pjgranieri/Portable-Real-Time-Poker-Assistant/data/Datasets/SampleGameDataset/Cards/HoleCards/ESP32S3_OV5640_249504.jpg

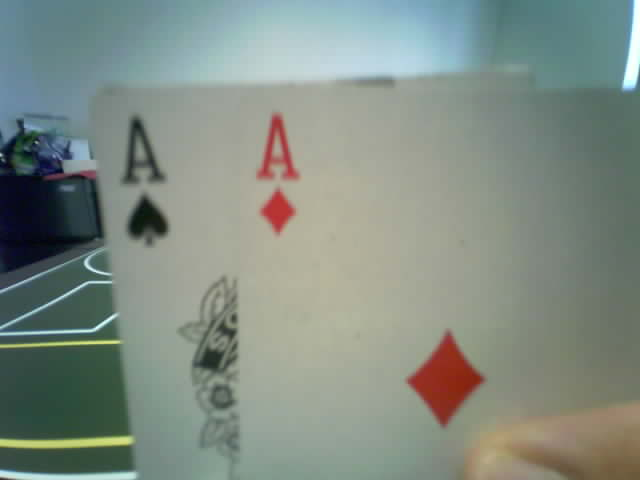
data/Datasets/SampleGameDataset/Cards/HoleCards/ESP32S3_OV5640_249504.jpg
