pjgranieri/Portable-Real-Time-Poker-Assistant/data/Datasets/SampleGameDataset/BettingCycles/RiverBetting/P2/Check/ESP32S3_OV5640_711521.jpg

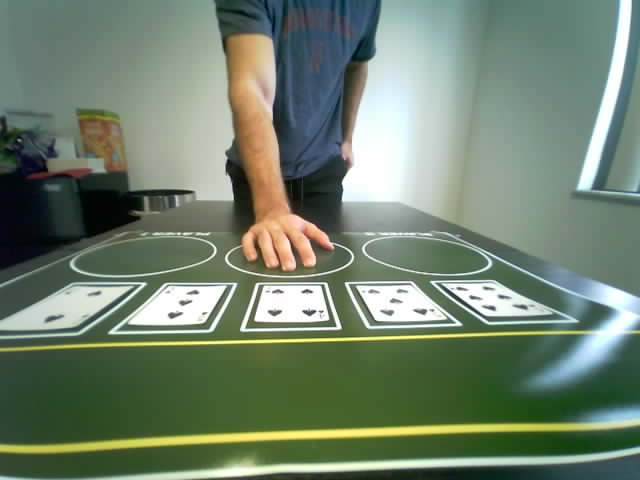
data/Datasets/SampleGameDataset/BettingCycles/RiverBetting/P2/Check/ESP32S3_OV5640_711521.jpg
