pjgranieri/Portable-Real-Time-Poker-Assistant/data/Datasets/CVDataset/BlackChips/1Chip/ESP32S3_OV5640_27438.jpg

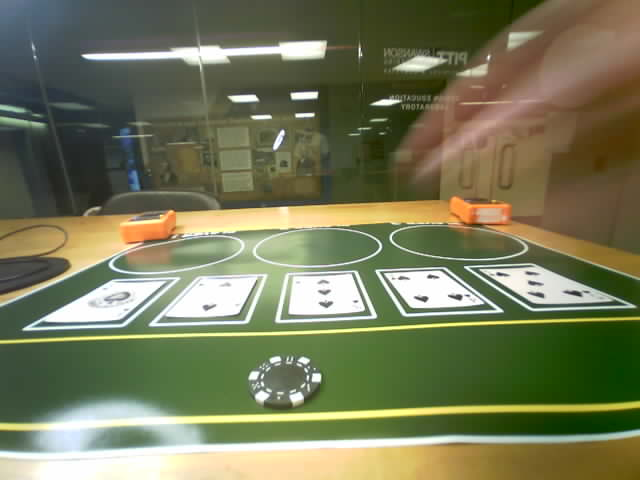
data/Datasets/CVDataset/BlackChips/1Chip/ESP32S3_OV5640_27438.jpg
