pjgranieri/Portable-Real-Time-Poker-Assistant/data/Datasets/CVDataset/BlackChips/1Chip/ESP32S3_OV5640_32523.jpg

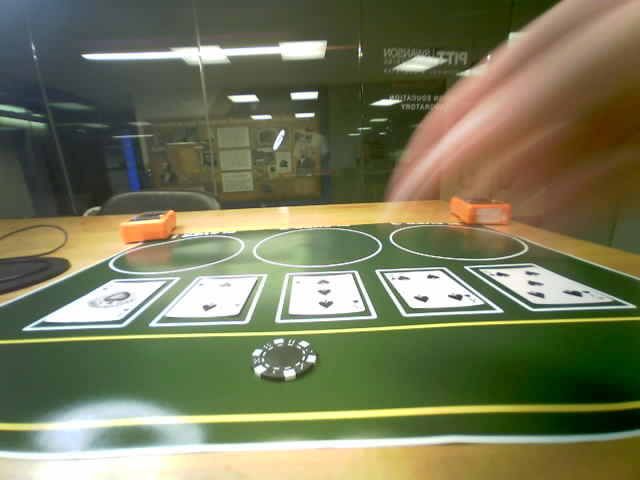
data/Datasets/CVDataset/BlackChips/1Chip/ESP32S3_OV5640_32523.jpg
