pjgranieri/Portable-Real-Time-Poker-Assistant/data/Datasets/CVDataset/BlackChips/1Chip/ESP32S3_OV5640_39970.jpg

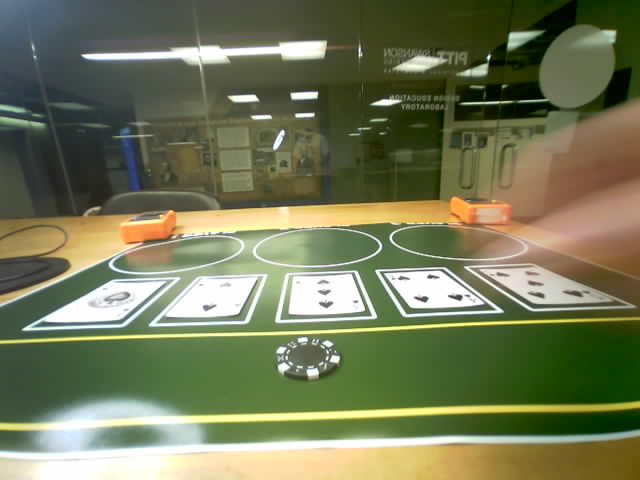
data/Datasets/CVDataset/BlackChips/1Chip/ESP32S3_OV5640_39970.jpg
