pjgranieri/Portable-Real-Time-Poker-Assistant/data/Datasets/CVDataset/BlackChips/2Chips/ESP32S3_OV5640_853156.jpg

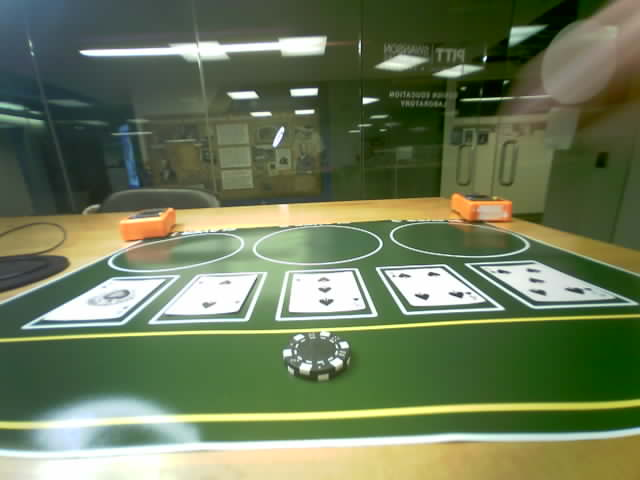
data/Datasets/CVDataset/BlackChips/2Chips/ESP32S3_OV5640_853156.jpg
