pjgranieri/Portable-Real-Time-Poker-Assistant/data/Datasets/CVDataset/BlackChips/3Chips/ESP32S3_OV5640_737669.jpg

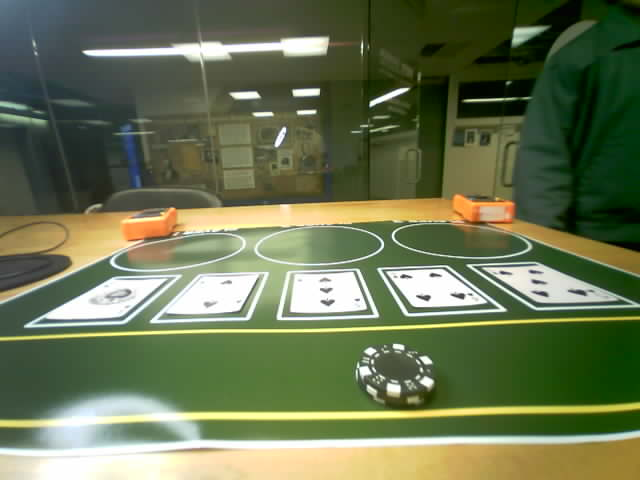
data/Datasets/CVDataset/BlackChips/3Chips/ESP32S3_OV5640_737669.jpg
