pjgranieri/Portable-Real-Time-Poker-Assistant/data/Datasets/CVDataset/BlackChips/4Chips/ESP32S3_OV5640_536933.jpg

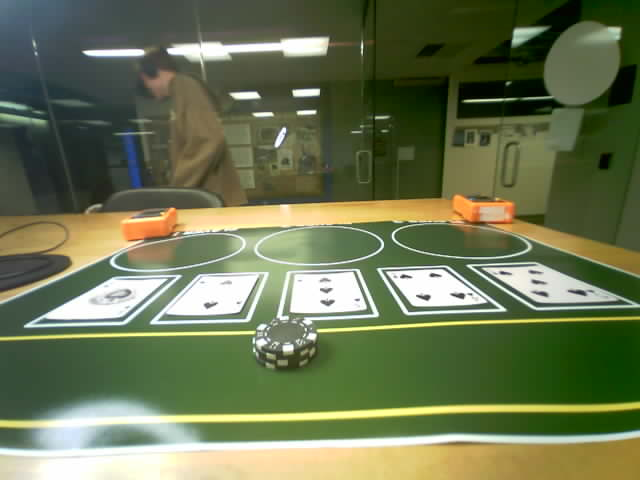
data/Datasets/CVDataset/BlackChips/4Chips/ESP32S3_OV5640_536933.jpg
