pjgranieri/Portable-Real-Time-Poker-Assistant/data/Datasets/CVDataset/BlackChips/4Chips/ESP32S3_OV5640_538406.jpg

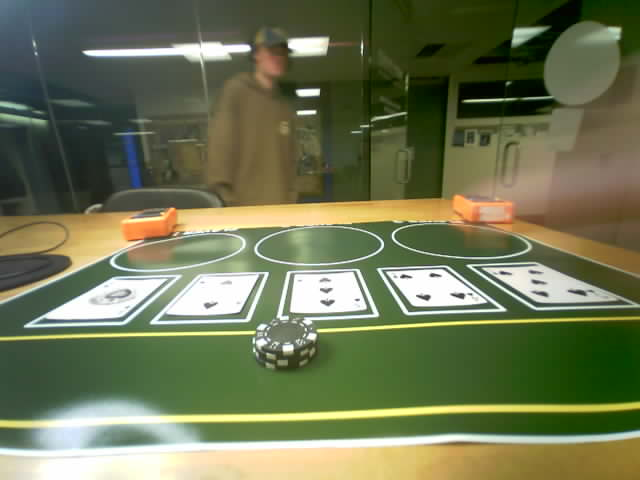
data/Datasets/CVDataset/BlackChips/4Chips/ESP32S3_OV5640_538406.jpg
