pjgranieri/Portable-Real-Time-Poker-Assistant/data/Datasets/CVDataset/BlackChips/5Chips/ESP32S3_OV5640_432432.jpg

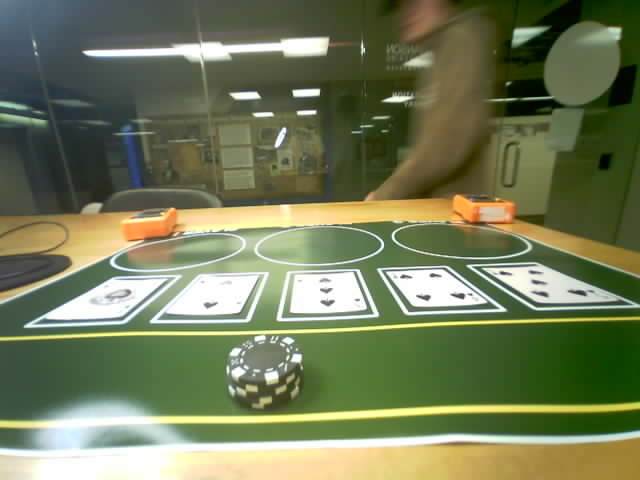
data/Datasets/CVDataset/BlackChips/5Chips/ESP32S3_OV5640_432432.jpg
