pjgranieri/Portable-Real-Time-Poker-Assistant/data/Datasets/CVDataset/BlueChips/1Chip/ESP32S3_OV5640_324995.jpg

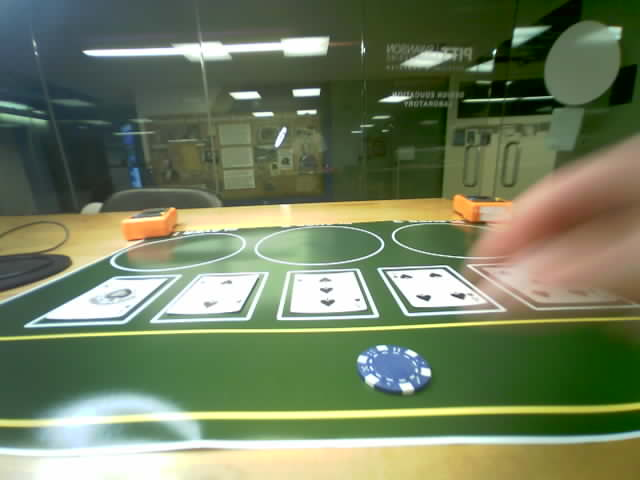
data/Datasets/CVDataset/BlueChips/1Chip/ESP32S3_OV5640_324995.jpg
