pjgranieri/Portable-Real-Time-Poker-Assistant/data/Datasets/CVDataset/BlueChips/4Chips/ESP32S3_OV5640_423402.jpg

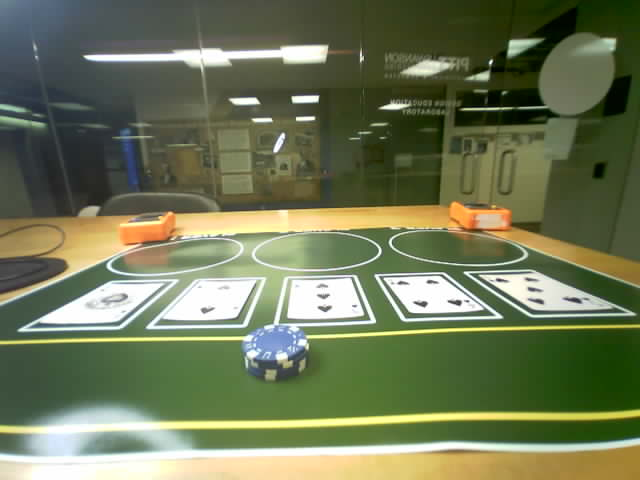
data/Datasets/CVDataset/BlueChips/4Chips/ESP32S3_OV5640_423402.jpg
