pjgranieri/Portable-Real-Time-Poker-Assistant/data/Datasets/CVDataset/BlueChips/4Chips/ESP32S3_OV5640_431127.jpg

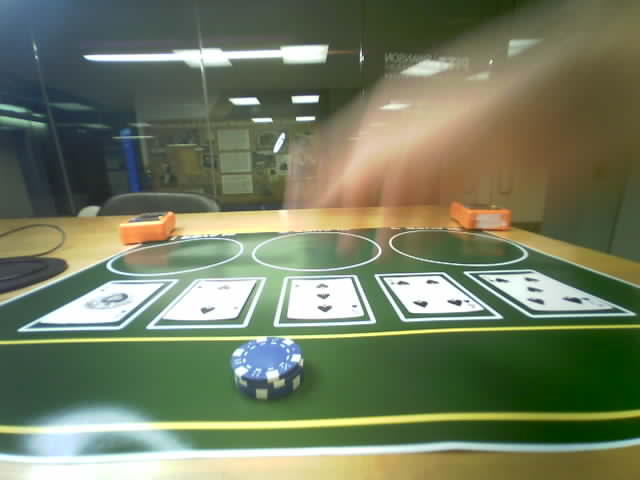
data/Datasets/CVDataset/BlueChips/4Chips/ESP32S3_OV5640_431127.jpg
