pjgranieri/Portable-Real-Time-Poker-Assistant/data/Datasets/CVDataset/BlueChips/4Chips/ESP32S3_OV5640_457952.jpg

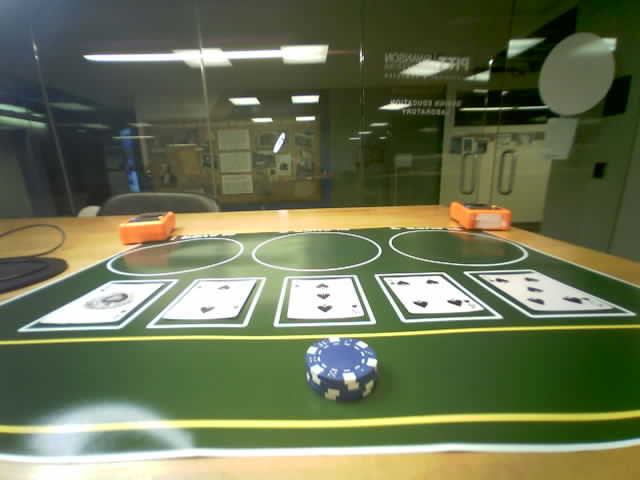
data/Datasets/CVDataset/BlueChips/4Chips/ESP32S3_OV5640_457952.jpg
