pjgranieri/Portable-Real-Time-Poker-Assistant/data/Datasets/CVDataset/RedChips/3Chips/ESP32S3_OV5640_774054.jpg

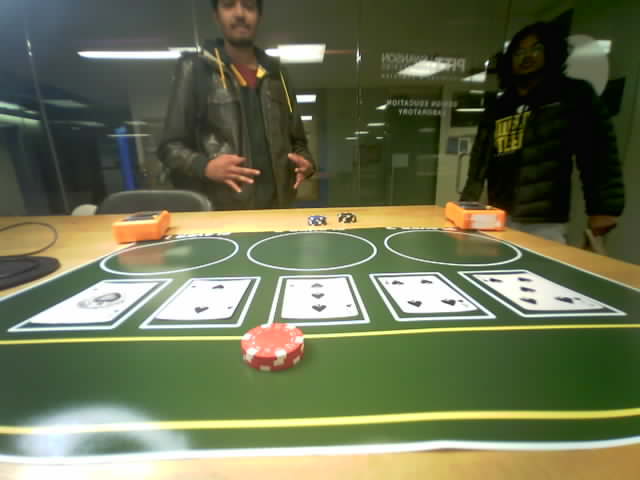
data/Datasets/CVDataset/RedChips/3Chips/ESP32S3_OV5640_774054.jpg
