pjgranieri/Portable-Real-Time-Poker-Assistant/data/Datasets/CVDataset/RedChips/3Chips/ESP32S3_OV5640_810843.jpg

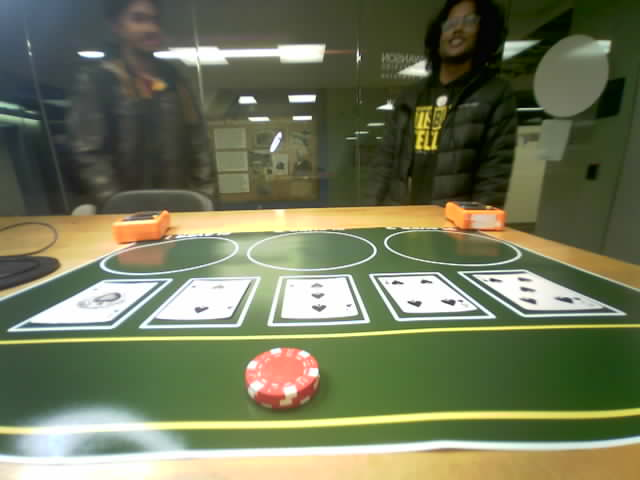
data/Datasets/CVDataset/RedChips/3Chips/ESP32S3_OV5640_810843.jpg
