pjgranieri/Portable-Real-Time-Poker-Assistant/data/Datasets/CVDataset/RedChips/3Chips/ESP32S3_OV5640_822369.jpg

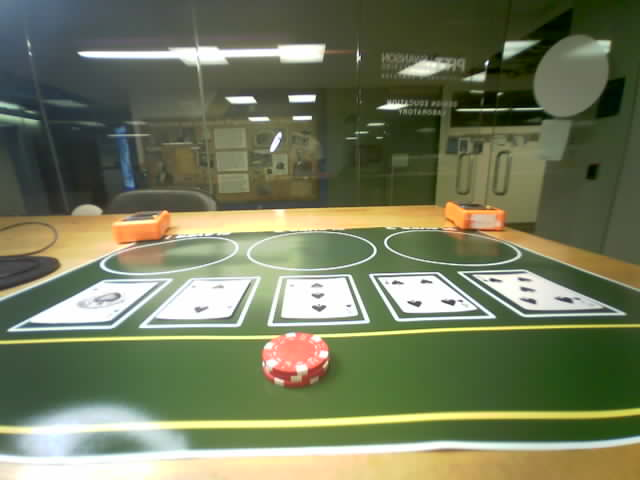
data/Datasets/CVDataset/RedChips/3Chips/ESP32S3_OV5640_822369.jpg
