pjgranieri/Portable-Real-Time-Poker-Assistant/data/Datasets/CVDataset/RedChips/3Chips/ESP32S3_OV5640_870761.jpg

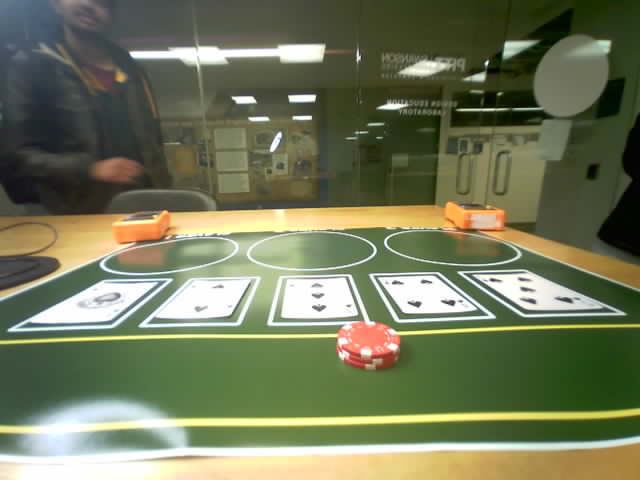
data/Datasets/CVDataset/RedChips/3Chips/ESP32S3_OV5640_870761.jpg
