pjgranieri/Portable-Real-Time-Poker-Assistant/data/Datasets/CVDataset/RedChips/5Chips/ESP32S3_OV5640_233298.jpg

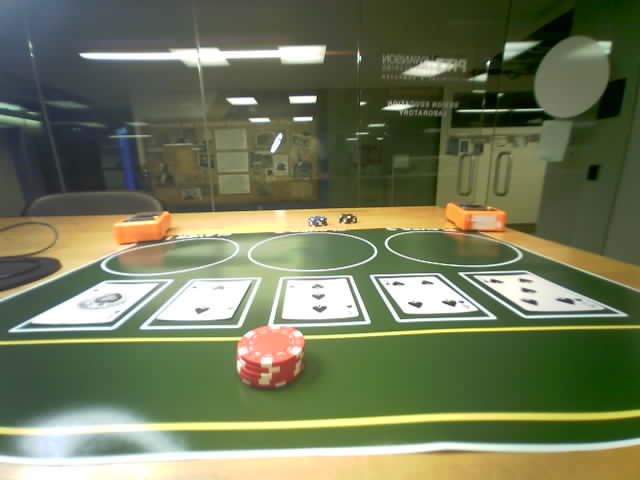
data/Datasets/CVDataset/RedChips/5Chips/ESP32S3_OV5640_233298.jpg
