pjgranieri/Portable-Real-Time-Poker-Assistant/data/Datasets/CVDataset/RedChips/5Chips/ESP32S3_OV5640_341674.jpg

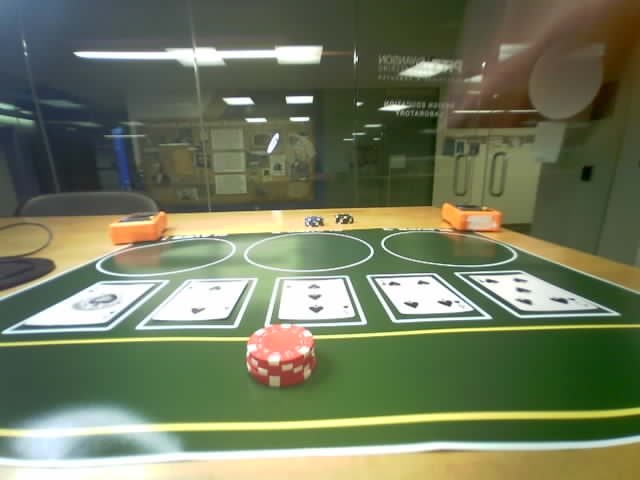
data/Datasets/CVDataset/RedChips/5Chips/ESP32S3_OV5640_341674.jpg
