pjgranieri/Portable-Real-Time-Poker-Assistant/data/Datasets/SampleGameDataset/BettingCycles/FlopBetting/P1/BlueChips/ESP32S3_OV5640_871948.jpg

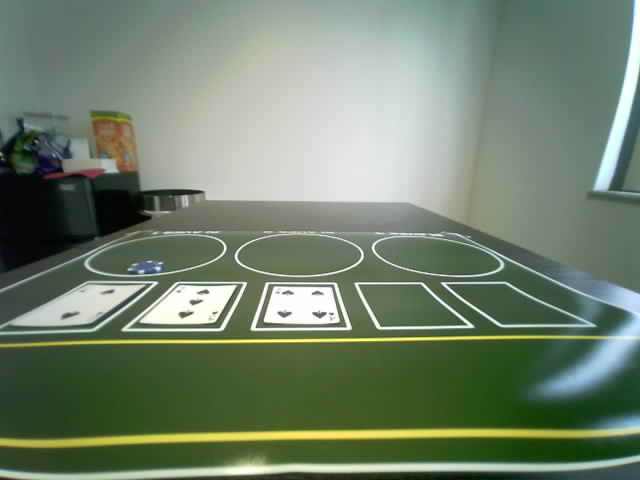
data/Datasets/SampleGameDataset/BettingCycles/FlopBetting/P1/BlueChips/ESP32S3_OV5640_871948.jpg
