pjgranieri/Portable-Real-Time-Poker-Assistant/data/Datasets/SampleGameDataset/BettingCycles/FlopBetting/P1/Check/ESP32S3_OV5640_1007601.jpg

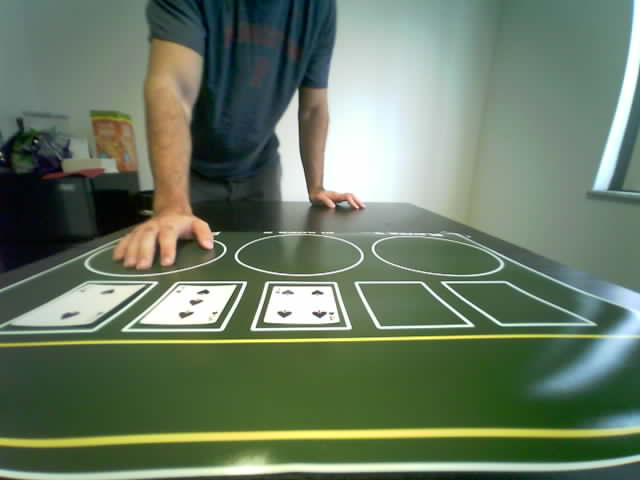
data/Datasets/SampleGameDataset/BettingCycles/FlopBetting/P1/Check/ESP32S3_OV5640_1007601.jpg
