pjgranieri/Portable-Real-Time-Poker-Assistant/data/Datasets/SampleGameDataset/BettingCycles/FlopBetting/P1/Fold/ESP32S3_OV5640_947596.jpg

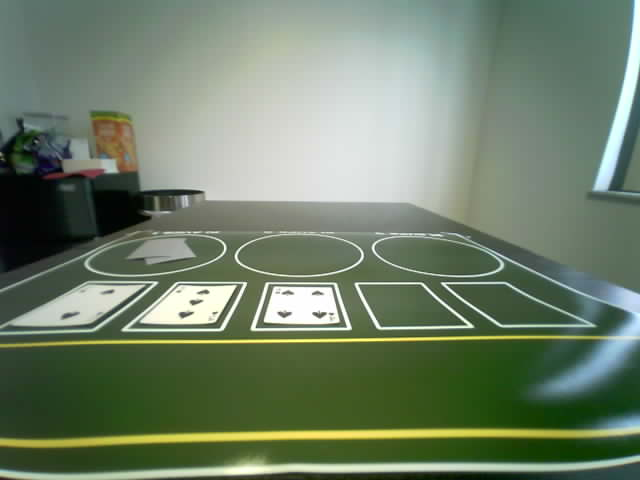
data/Datasets/SampleGameDataset/BettingCycles/FlopBetting/P1/Fold/ESP32S3_OV5640_947596.jpg
