pjgranieri/Portable-Real-Time-Poker-Assistant/data/Datasets/SampleGameDataset/BettingCycles/FlopBetting/P2/BlueChips/ESP32S3_OV5640_1161729.jpg

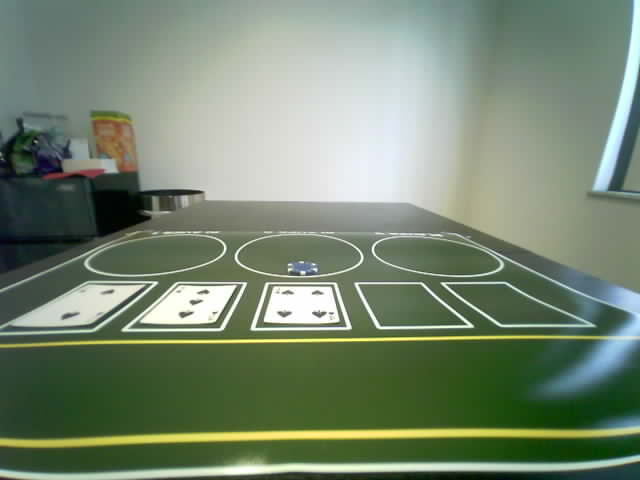
data/Datasets/SampleGameDataset/BettingCycles/FlopBetting/P2/BlueChips/ESP32S3_OV5640_1161729.jpg
