pjgranieri/Portable-Real-Time-Poker-Assistant/data/Datasets/SampleGameDataset/BettingCycles/FlopBetting/P2/Fold/ESP32S3_OV5640_1222649.jpg

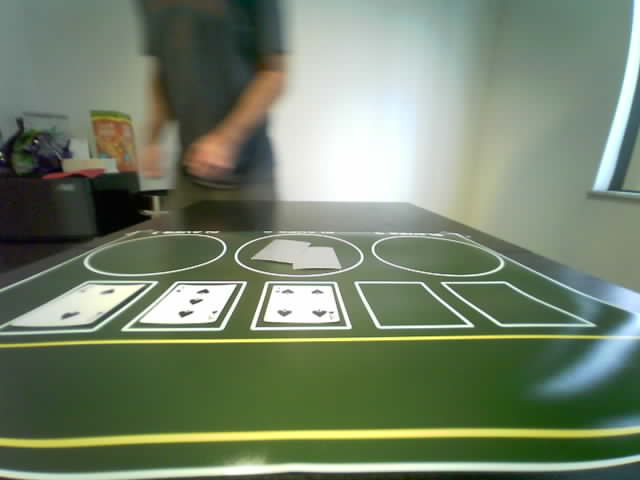
data/Datasets/SampleGameDataset/BettingCycles/FlopBetting/P2/Fold/ESP32S3_OV5640_1222649.jpg
