pjgranieri/Portable-Real-Time-Poker-Assistant/data/Datasets/SampleGameDataset/BettingCycles/FlopBetting/P3/BlueChips/ESP32S3_OV5640_1355583.jpg

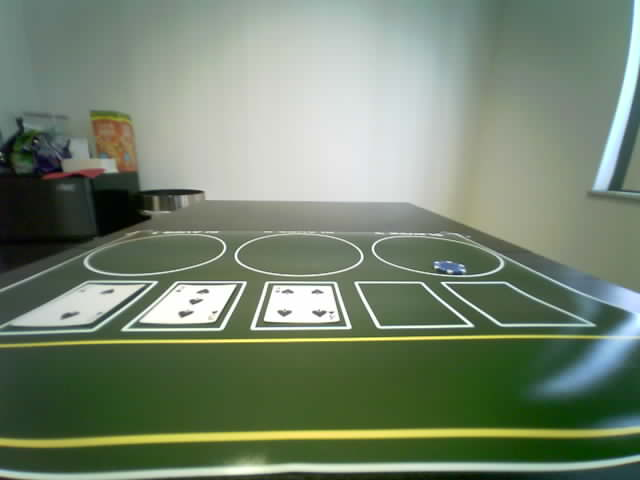
data/Datasets/SampleGameDataset/BettingCycles/FlopBetting/P3/BlueChips/ESP32S3_OV5640_1355583.jpg
