pjgranieri/Portable-Real-Time-Poker-Assistant/data/Datasets/SampleGameDataset/BettingCycles/FlopBetting/P3/Check/ESP32S3_OV5640_1460840.jpg

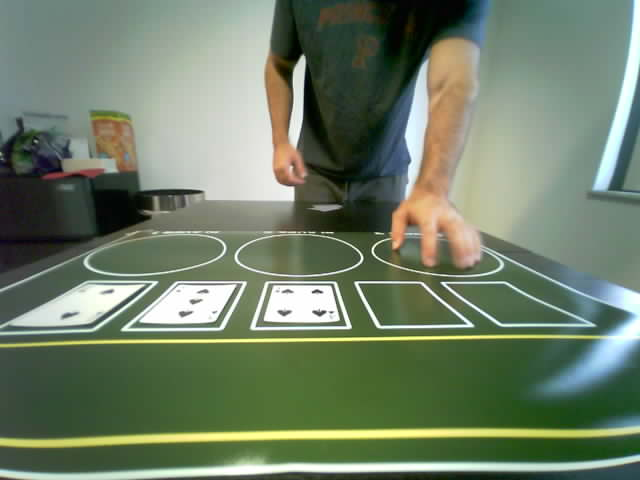
data/Datasets/SampleGameDataset/BettingCycles/FlopBetting/P3/Check/ESP32S3_OV5640_1460840.jpg
