pjgranieri/Portable-Real-Time-Poker-Assistant/data/Datasets/SampleGameDataset/BettingCycles/FlopBetting/P3/Fold/ESP32S3_OV5640_1443695.jpg

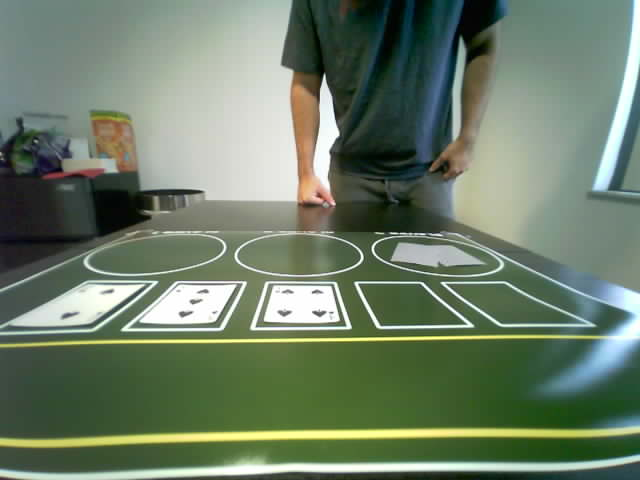
data/Datasets/SampleGameDataset/BettingCycles/FlopBetting/P3/Fold/ESP32S3_OV5640_1443695.jpg
