pjgranieri/Portable-Real-Time-Poker-Assistant/data/Datasets/SampleGameDataset/BettingCycles/RiverBetting/P1/BlueChips/ESP32S3_OV5640_500858.jpg

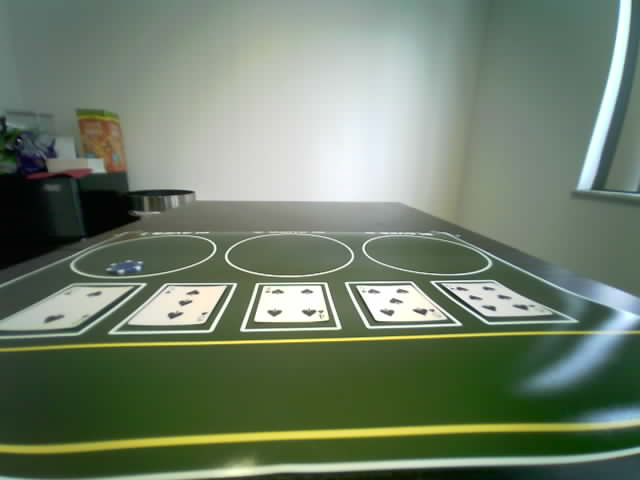
data/Datasets/SampleGameDataset/BettingCycles/RiverBetting/P1/BlueChips/ESP32S3_OV5640_500858.jpg
