pjgranieri/Portable-Real-Time-Poker-Assistant/data/Datasets/SampleGameDataset/BettingCycles/RiverBetting/P1/Check/ESP32S3_OV5640_586426.jpg

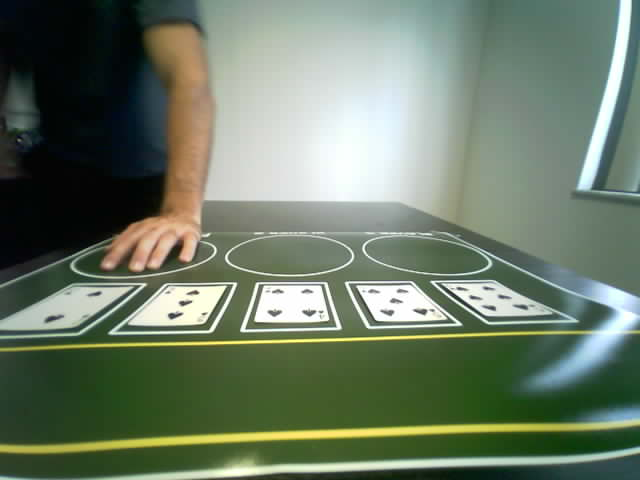
data/Datasets/SampleGameDataset/BettingCycles/RiverBetting/P1/Check/ESP32S3_OV5640_586426.jpg
