pjgranieri/Portable-Real-Time-Poker-Assistant/data/Datasets/SampleGameDataset/BettingCycles/RiverBetting/P1/Fold/ESP32S3_OV5640_572687.jpg

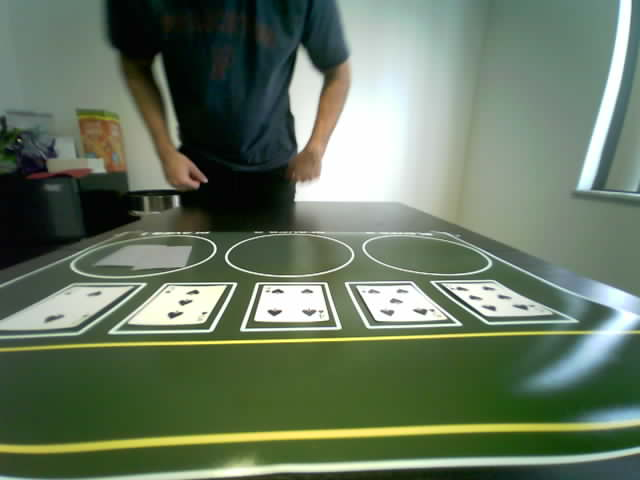
data/Datasets/SampleGameDataset/BettingCycles/RiverBetting/P1/Fold/ESP32S3_OV5640_572687.jpg
