pjgranieri/Portable-Real-Time-Poker-Assistant/data/Datasets/SampleGameDataset/BettingCycles/RiverBetting/P2/Fold/ESP32S3_OV5640_704866.jpg

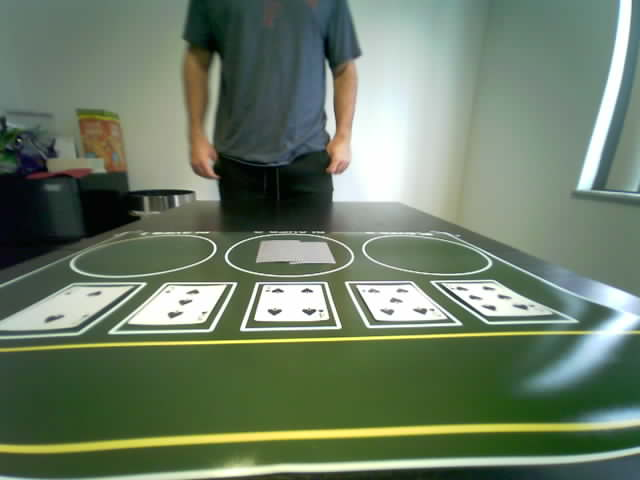
data/Datasets/SampleGameDataset/BettingCycles/RiverBetting/P2/Fold/ESP32S3_OV5640_704866.jpg
