pjgranieri/Portable-Real-Time-Poker-Assistant/data/Datasets/SampleGameDataset/BettingCycles/RiverBetting/P3/Check/ESP32S3_OV5640_870797.jpg

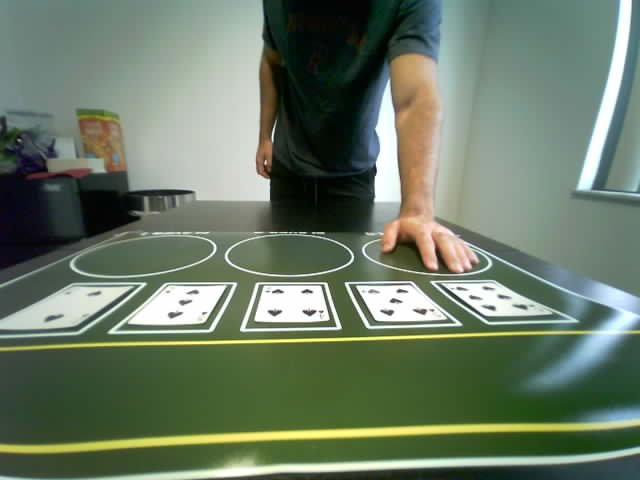
data/Datasets/SampleGameDataset/BettingCycles/RiverBetting/P3/Check/ESP32S3_OV5640_870797.jpg
