pjgranieri/Portable-Real-Time-Poker-Assistant/data/Datasets/SampleGameDataset/BettingCycles/RiverBetting/P3/Fold/ESP32S3_OV5640_845770.jpg

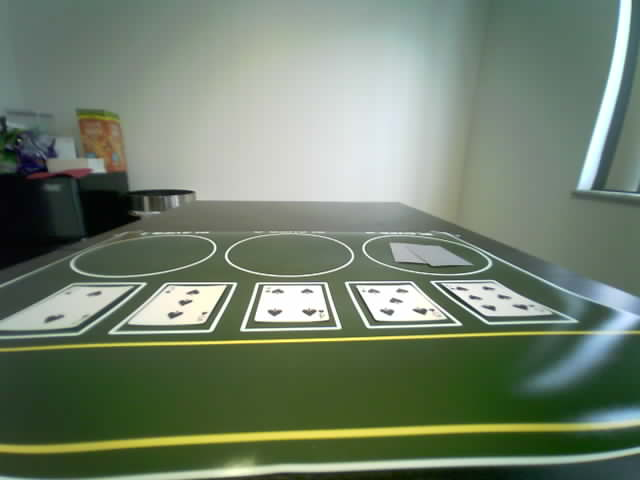
data/Datasets/SampleGameDataset/BettingCycles/RiverBetting/P3/Fold/ESP32S3_OV5640_845770.jpg
