pjgranieri/Portable-Real-Time-Poker-Assistant/data/Datasets/SampleGameDataset/BettingCycles/TurnBetting/P1/Fold/ESP32S3_OV5640_2066026.jpg

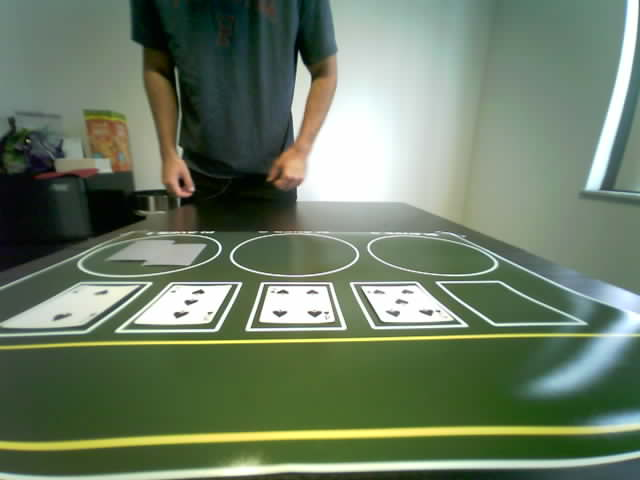
data/Datasets/SampleGameDataset/BettingCycles/TurnBetting/P1/Fold/ESP32S3_OV5640_2066026.jpg
