pjgranieri/Portable-Real-Time-Poker-Assistant/data/Datasets/SampleGameDataset/BettingCycles/TurnBetting/P2/Check/ESP32S3_OV5640_2253727.jpg

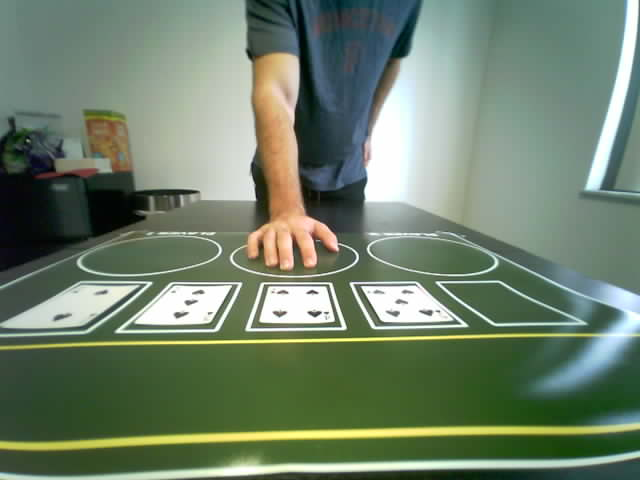
data/Datasets/SampleGameDataset/BettingCycles/TurnBetting/P2/Check/ESP32S3_OV5640_2253727.jpg
