pjgranieri/Portable-Real-Time-Poker-Assistant/data/Datasets/SampleGameDataset/BettingCycles/TurnBetting/P2/Fold/ESP32S3_OV5640_2238307.jpg

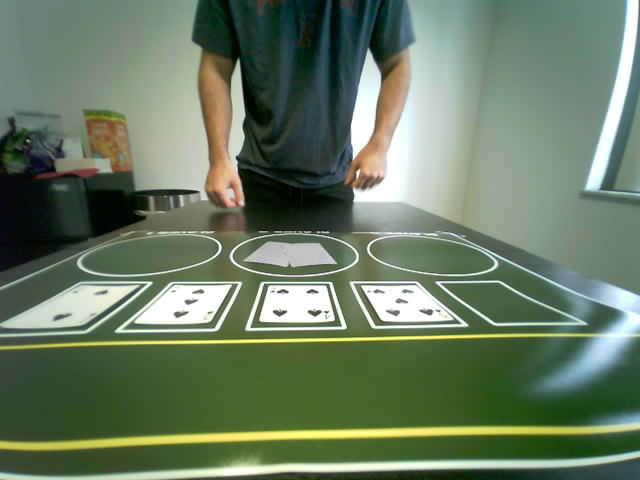
data/Datasets/SampleGameDataset/BettingCycles/TurnBetting/P2/Fold/ESP32S3_OV5640_2238307.jpg
