pjgranieri/Portable-Real-Time-Poker-Assistant/data/Datasets/SampleGameDataset/BettingCycles/TurnBetting/P3/Check/ESP32S3_OV5640_123956.jpg

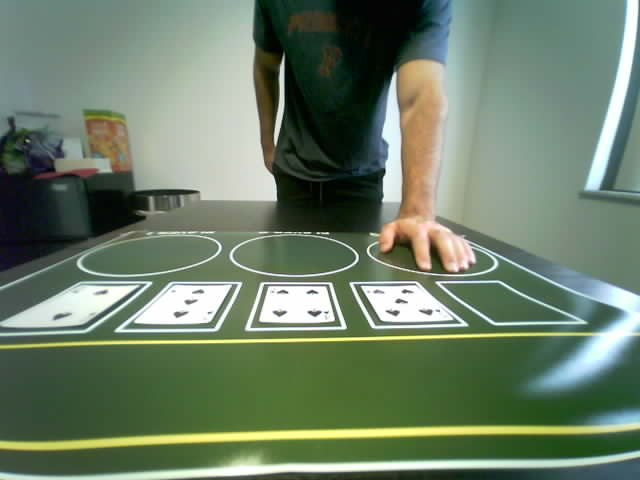
data/Datasets/SampleGameDataset/BettingCycles/TurnBetting/P3/Check/ESP32S3_OV5640_123956.jpg
