pjgranieri/Portable-Real-Time-Poker-Assistant/data/Datasets/SampleGameDataset/BettingCycles/TurnBetting/P3/RedChips/ESP32S3_OV5640_59251.jpg

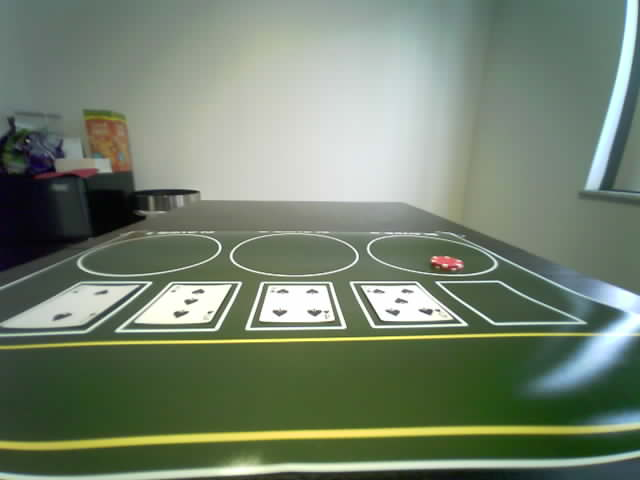
data/Datasets/SampleGameDataset/BettingCycles/TurnBetting/P3/RedChips/ESP32S3_OV5640_59251.jpg
