pjgranieri/Portable-Real-Time-Poker-Assistant/data/Datasets/SampleGameDataset/Cards/FlopCards/ESP32S3_OV5640_550835.jpg

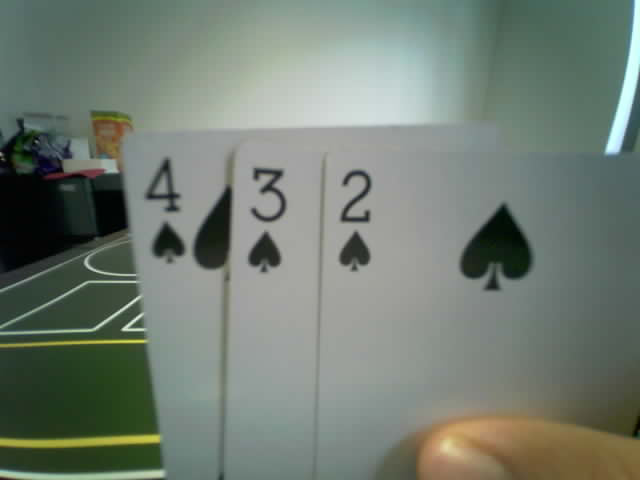
data/Datasets/SampleGameDataset/Cards/FlopCards/ESP32S3_OV5640_550835.jpg
