pjgranieri/Portable-Real-Time-Poker-Assistant/data/Datasets/SampleGameDataset/Cards/HoleCards/ESP32S3_OV5640_187406.jpg

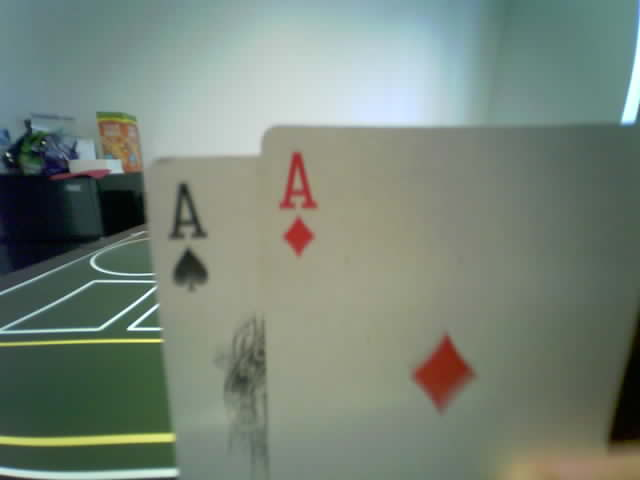
data/Datasets/SampleGameDataset/Cards/HoleCards/ESP32S3_OV5640_187406.jpg
