pjgranieri/Portable-Real-Time-Poker-Assistant/data/Datasets/SampleGameDataset/Cards/HoleCards/ESP32S3_OV5640_254482.jpg

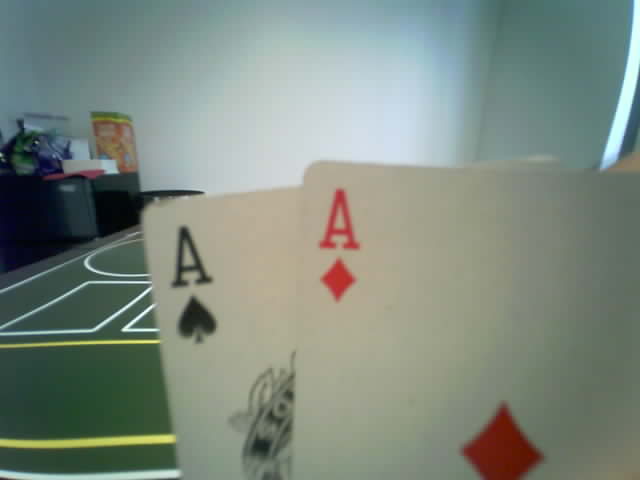
data/Datasets/SampleGameDataset/Cards/HoleCards/ESP32S3_OV5640_254482.jpg
