pjgranieri/Portable-Real-Time-Poker-Assistant/data/Datasets/SampleGameDataset/Cards/RiverCard/ESP32S3_OV5640_295957.jpg

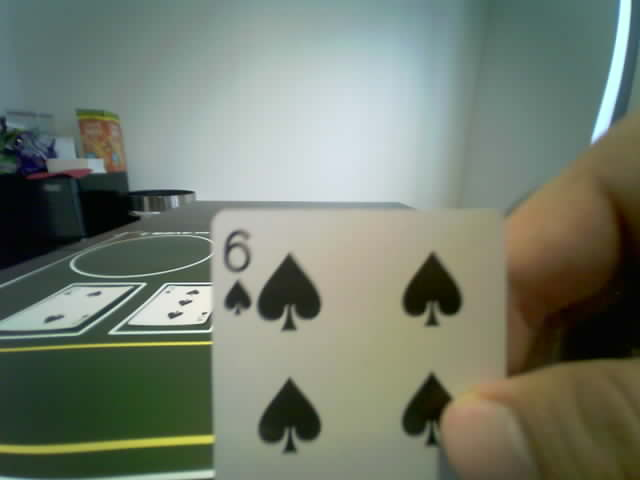
data/Datasets/SampleGameDataset/Cards/RiverCard/ESP32S3_OV5640_295957.jpg
