pjgranieri/Portable-Real-Time-Poker-Assistant/data/Datasets/SampleGameDataset/Cards/RiverCard/ESP32S3_OV5640_302021.jpg

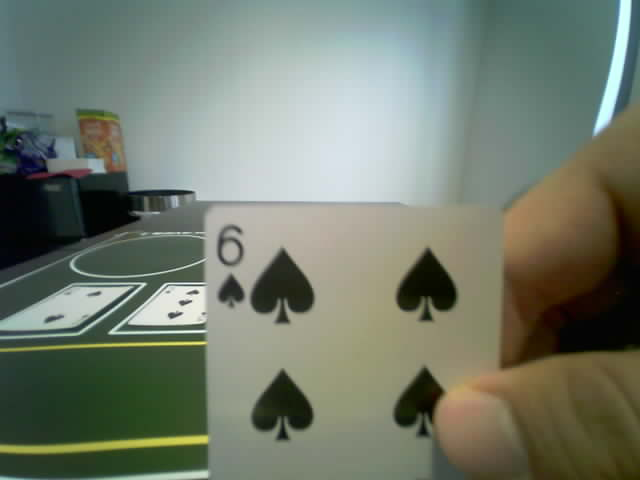
data/Datasets/SampleGameDataset/Cards/RiverCard/ESP32S3_OV5640_302021.jpg
