pjgranieri/Portable-Real-Time-Poker-Assistant/data/Datasets/SampleGameDataset/Cards/TurnCard/ESP32S3_OV5640_1627963.jpg

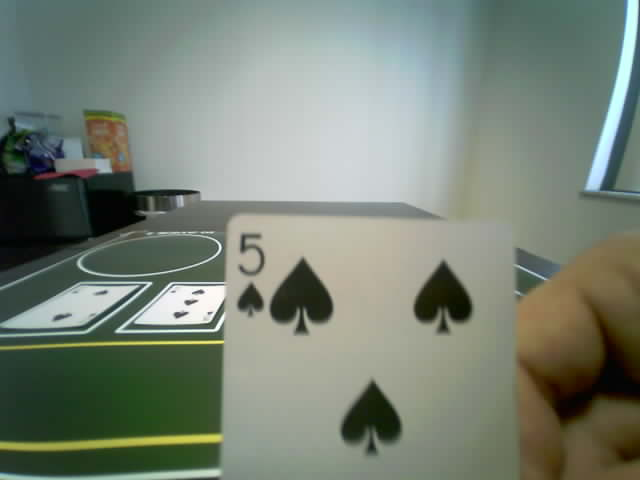
data/Datasets/SampleGameDataset/Cards/TurnCard/ESP32S3_OV5640_1627963.jpg
