pjgranieri/Portable-Real-Time-Poker-Assistant/data/Datasets/SampleGameDataset/Cards/TurnCard/ESP32S3_OV5640_1635533.jpg

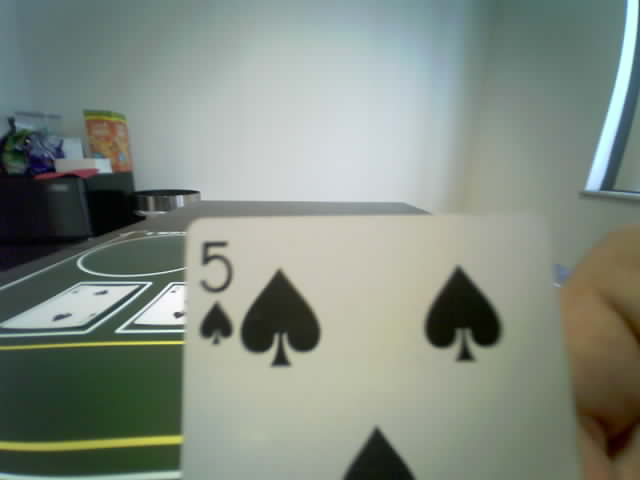
data/Datasets/SampleGameDataset/Cards/TurnCard/ESP32S3_OV5640_1635533.jpg
