pjgranieri/Portable-Real-Time-Poker-Assistant/data/Datasets/SampleGameDataset/PotAmounts/Red/1Chip/ESP32S3_OV5640_643999.jpg

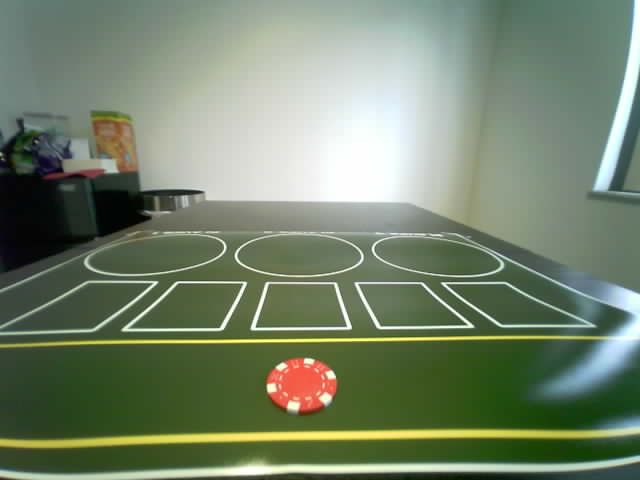
data/Datasets/SampleGameDataset/PotAmounts/Red/1Chip/ESP32S3_OV5640_643999.jpg
