pjgranieri/Portable-Real-Time-Poker-Assistant/data/Datasets/SampleGameDataset/PotAmounts/Red/2Chips/ESP32S3_OV5640_676153.jpg

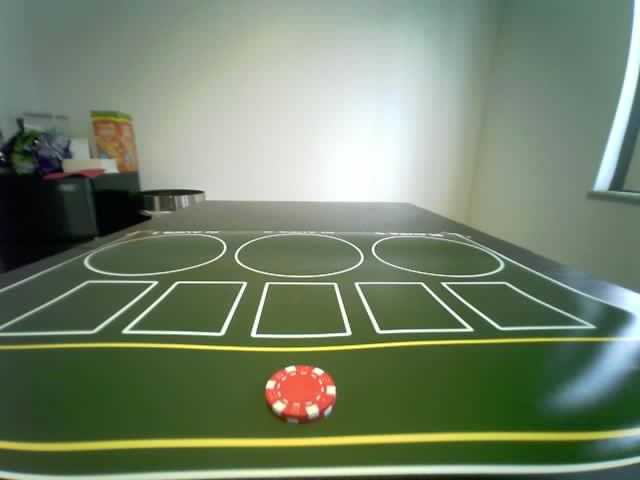
data/Datasets/SampleGameDataset/PotAmounts/Red/2Chips/ESP32S3_OV5640_676153.jpg
