pjgranieri/Portable-Real-Time-Poker-Assistant/data/Datasets/SampleGameDataset/PotAmounts/Red/2Chips/ESP32S3_OV5640_1024321.jpg

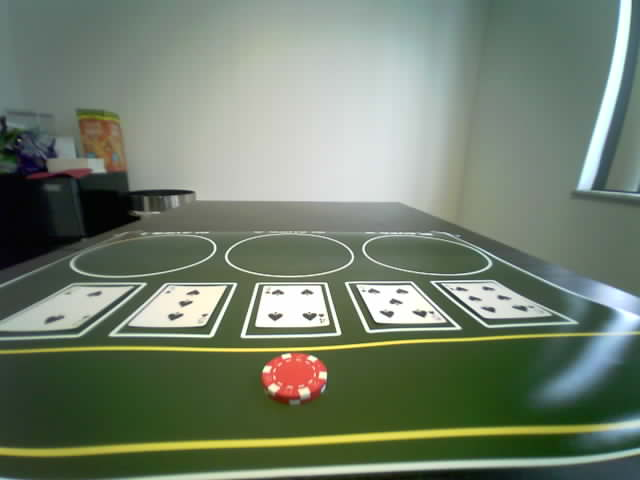
data/Datasets/SampleGameDataset/PotAmounts/Red/2Chips/ESP32S3_OV5640_1024321.jpg
