pjgranieri/Portable-Real-Time-Poker-Assistant/src/runs/poker_mlp_v1/confusion_matrix.png

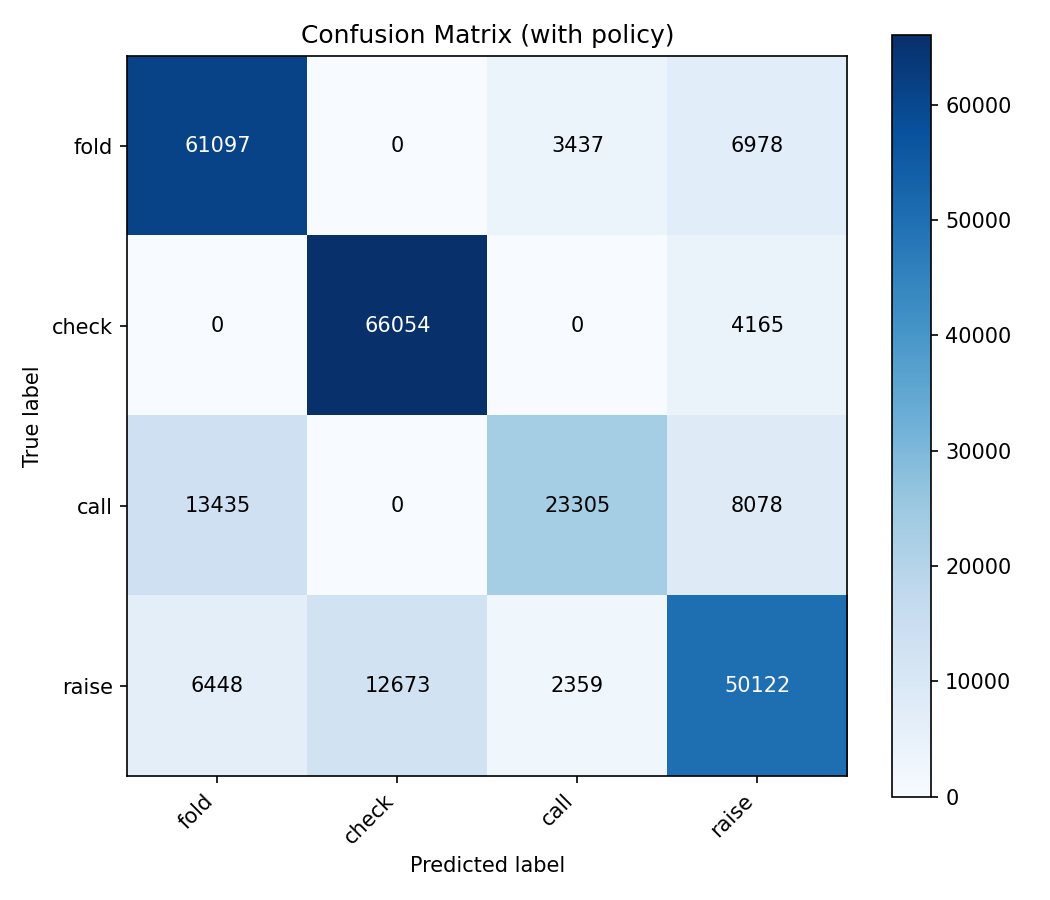
src/runs/poker_mlp_v1/confusion_matrix.png
