pjgranieri/Portable-Real-Time-Poker-Assistant/src/runs/poker_mlp_v1/gui_demo_log.csv

round | position | whos_turn | hole1 | hole2 | flop1 | flop2 | flop3 | turn | river | pot_bb | to_call_bb | hero_stack_bb | opp_stack_bb | effective_stack_bb | spr | raise_to_bb | bet_frac_of_pot | bet_frac_of_pot_clipped | is_allin | action | p_fold | p_check_call | p_raise_s | p_raise_m | p_raise_l | model_class
preflop | BTN | hero | 3c | 7c |  |  |  |  |  | 3.0 | 1.5 | 98.0 | 99.0 | 98.0 | 32.666666666666664 | 1.5 | 0.5 | 0.5 | 0.0 | raise | 0.0 | 3.86272358809947e-06 | 0.9999961853027344 | 0.0 | 4.264178221554035e-36 | raise_s
preflop | BB | villain | 3s | 7d |  |  |  |  |  | 4.5 | 0.0 | 98.0 | 97.5 | 97.5 | 21.666666666666668 | 0.0 | 0.0 | 0.0 | 0.0 | check
preflop | BTN | hero | 3c | 7c |  |  |  |  |  | 4.5 | 0.0 | 98.0 | 97.5 | 97.5 | 21.666666666666668 | 0.0 | 0.0 | 0.0 | 0.0 | check | 0.0 | 0.9999991655349731 | 8.416700438829139e-07 | 0.0 | 1.177341867491954e-25 | check_call
preflop | BB | villain | 3s | 7d |  |  |  |  |  | 4.5 | 0.0 | 98.0 | 97.5 | 97.5 | 21.666666666666668 | 0.0 | 0.0 | 0.0 | 0.0 | check
preflop | BTN | hero | 3c | 7c |  |  |  |  |  | 4.5 | 0.0 | 98.0 | 97.5 | 97.5 | 21.666666666666668 | 0.0 | 0.0 | 0.0 | 0.0 | check | 0.0 | 0.9999991655349731 | 8.416700438829139e-07 | 0.0 | 1.177341867491954e-25 | check_call
preflop | BTN | hero | 3d | 5h |  |  |  |  |  | 3.0 | 1.5 | 98.0 | 99.0 | 98.0 | 32.666666666666664 | 1.5 | 0.5 | 0.5 | 0.0 | raise | 0.0 | 1.0666063644748647e-05 | 0.99998939037323 | 0.0 | 4.1769857989381255e-36 | raise_s
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
preflop | SB | villain | 6c | Qs |  |  |  |  |  | 126.0 | 0.0 | 38.0 | 36.0 | 36.0 | 0.2857142857142857 | 2.0 | 0.015873015873015872 | 0.015873015873015872 | 0.0 | raise
preflop | BB | hero | Ad | Td |  |  |  |  |  | 128.0 | 2.0 | 36.0 | 36.0 | 36.0 | 0.28125 | 0.0 | 0.0 | 0.0 | 0.0 | call | 0.0 | 1.0 | 7.317560671055614e-36 | 0.0 | 0.0 | check_call
preflop | SB | villain | 6c | Qs |  |  |  |  |  | 130.0 | 0.0 | 36.0 | 34.0 | 34.0 | 0.26153846153846155 | 2.0 | 0.015384615384615385 | 0.015384615384615385 | 0.0 | raise
preflop | BB | hero | Ad | Td |  |  |  |  |  | 132.0 | 2.0 | 34.0 | 34.0 | 34.0 | 0.25757575757575757 | 0.0 | 0.0 | 0.0 | 0.0 | call | 0.0 | 1.0 | 5.527395994741639e-30 | 0.0 | 0.0 | check_call
