pjgranieri/Portable-Real-Time-Poker-Assistant/(commit log)

2025-09-10 ignoring the millions of poker hands for the github too much data
2025-09-22 almost finished the bot data creator just need to optomize for speed cause my computer sucks
    [superbot_training_data_patched.csv]
2025-10-01 Finalized the data creation for both the bots and the real data for sending to the ML model. The data is all in .csv format code all written in Python
    [superbot_training_data_patched.csv]
2025-10-04 Created Successful Connection between ESP32 and VM
2025-10-15 added some stuff
    [gui_demo_log.csv]
2025-11-06 Sample output provided
2025-11-07 added sample input to ML branch for integration
2025-11-09 Working camera upload
2025-11-09 Successful working camera with raw upload and server
2025-11-10 Working prototype
2025-11-17 Can successfully communicate actions to device
2025-12-05 Updated Repo Layout
    [gui_demo_log.csv]
